razordevel/elevator/hardware overview.jpg

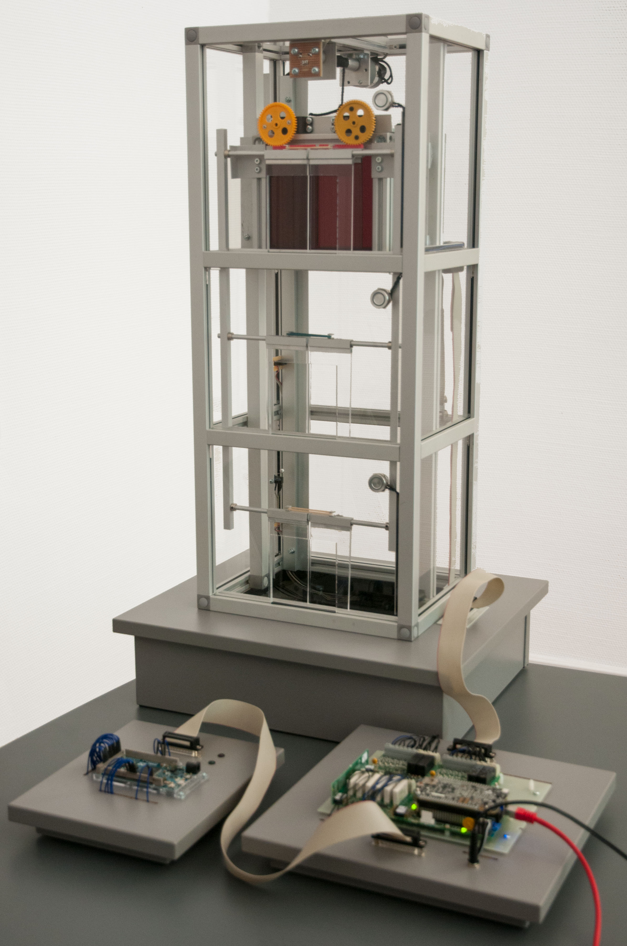
hardware overview.jpg
