razordevel/elevator/testsystem/test system.jpg

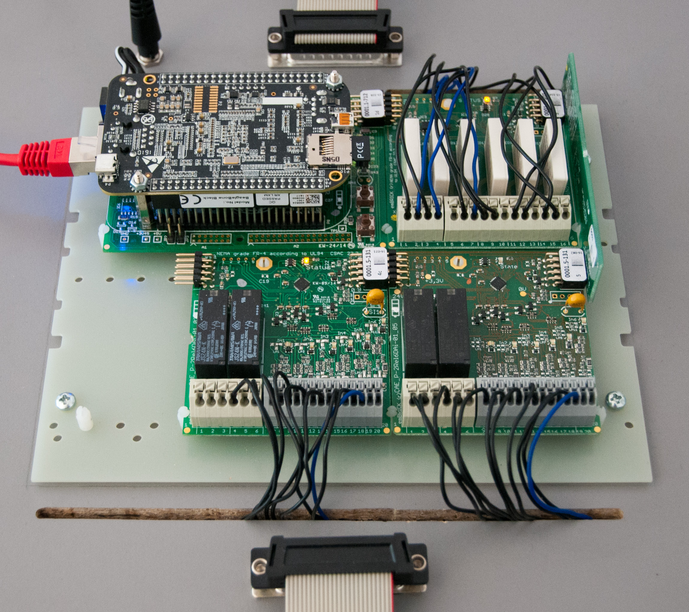
testsystem/test system.jpg
