razordevel/elevator/elevator/README.md

# Elevator

The frame of the elevator is constructed from 20mm x 20mm aluminium profiles. The walls are made out of plexiglas and are laser cutted.

The wiring picture shows how the different electrical components are wired inside the elevator.

The following list contains all major hardware components for the elevator:
#TBD

The following schematics show the assembling of the major hardware components of the elevator:
#TBD
