razordevel/elevator/elevator/Cabin Top.jpg

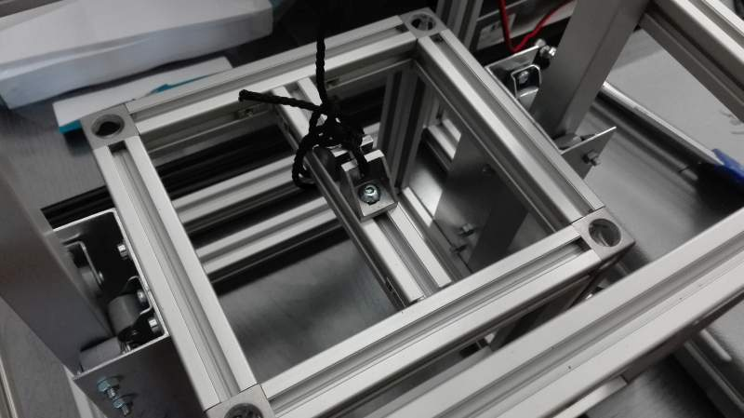
elevator/Cabin Top.jpg
