razordevel/elevator/elevator/Cabin Wheels.jpg

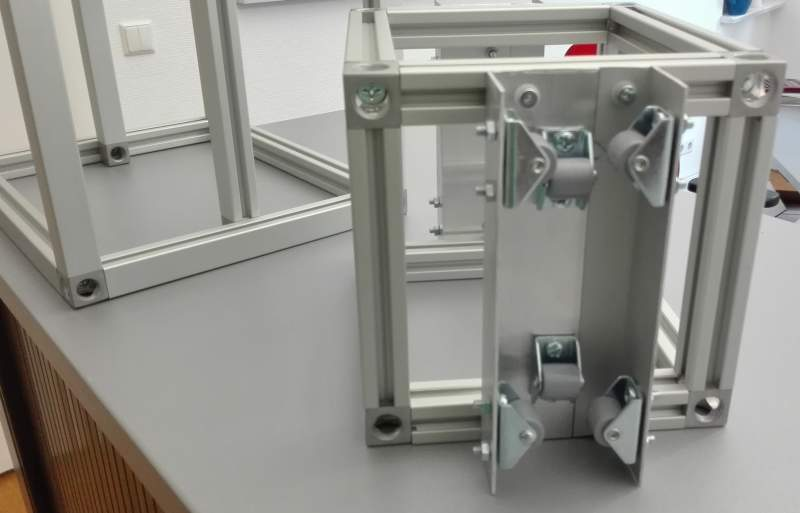
elevator/Cabin Wheels.jpg
