razordevel/elevator/elevator/Cabin.jpg

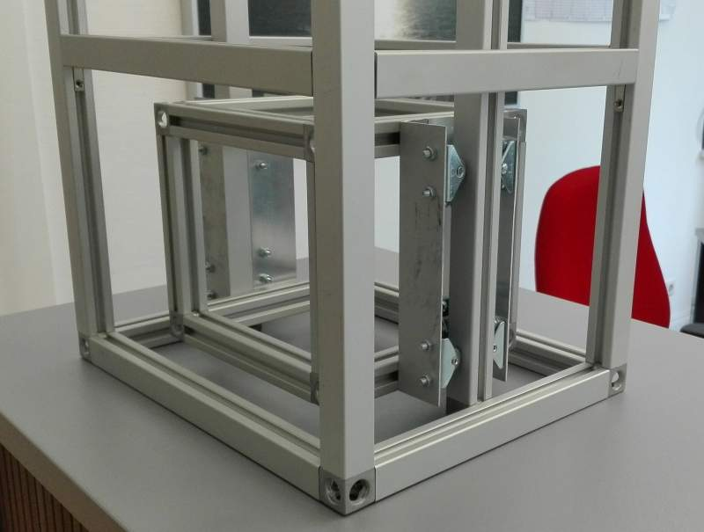
elevator/Cabin.jpg
