razordevel/elevator/elevator/Frame.jpg

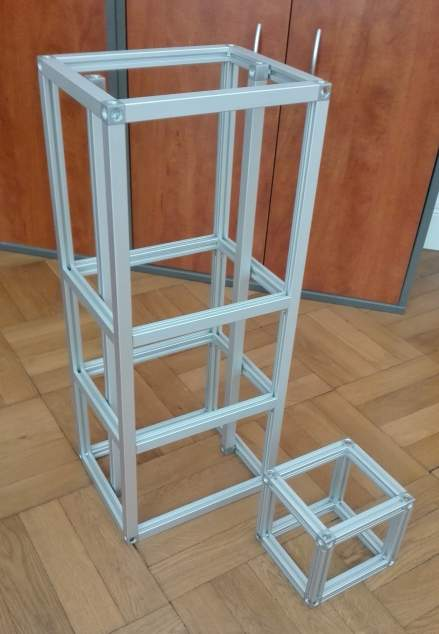
elevator/Frame.jpg
