razordevel/elevator/elevator/Motor.jpg

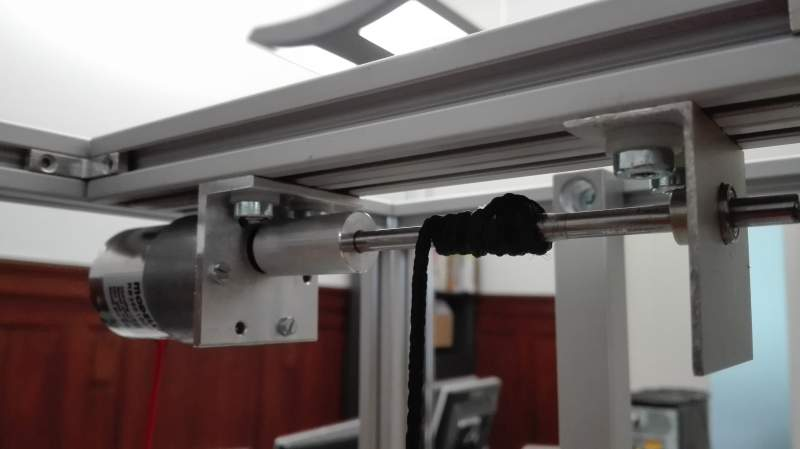
elevator/Motor.jpg
