razordevel/elevator/elevator/Overview.png

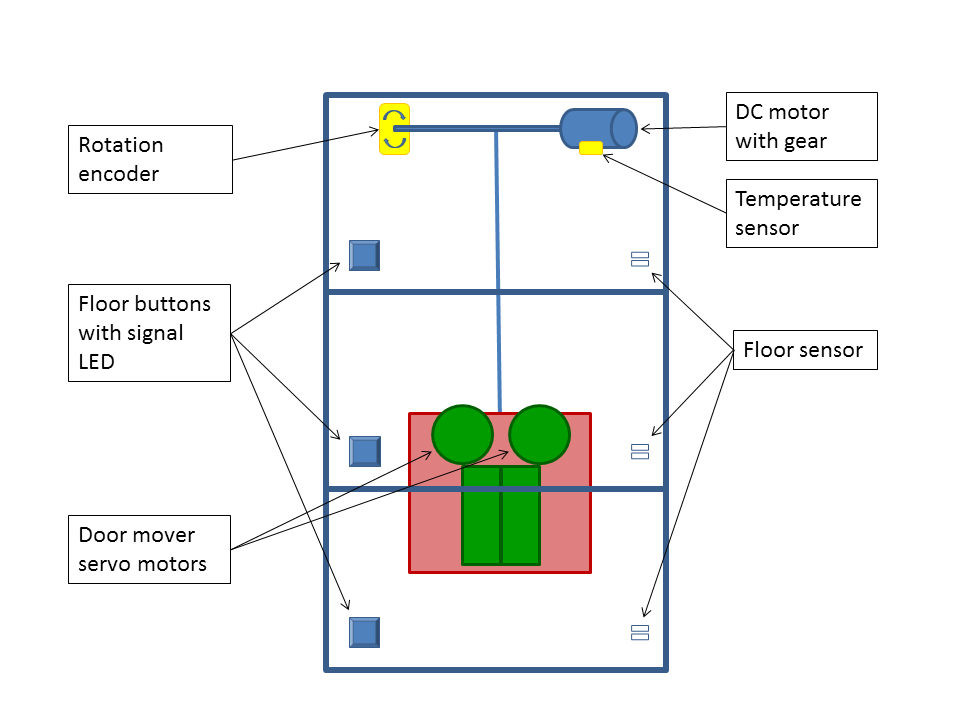
elevator/Overview.png
