razordevel/elevator/component overview.png

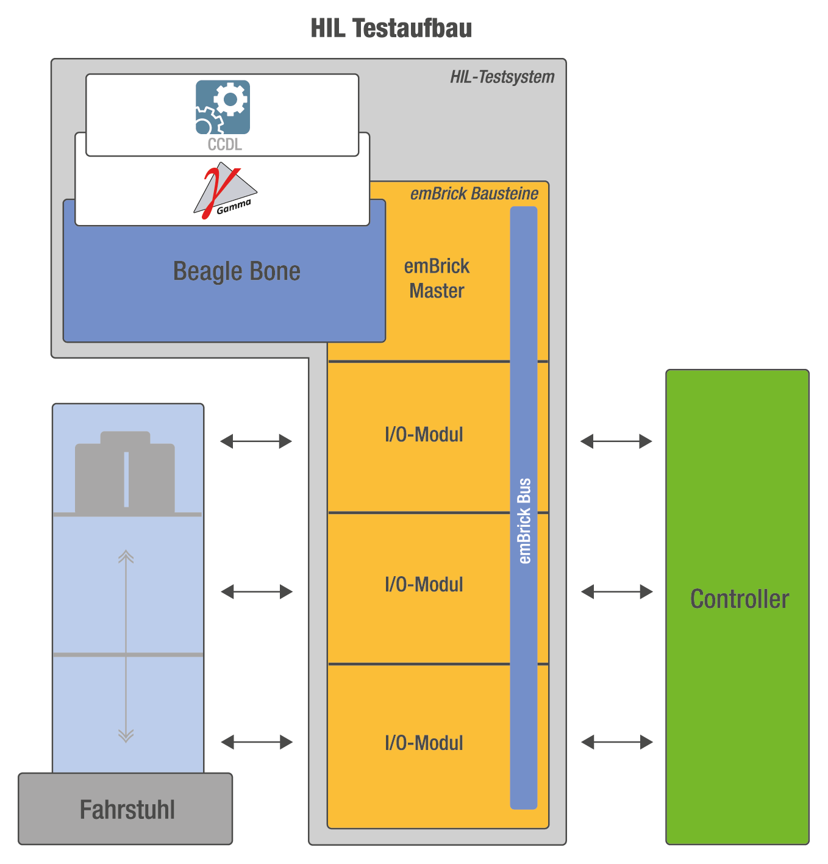
component overview.png
