razordevel/elevator/testsystem/ccdl/userfunctions/tests/00build-succeeds/README

Tests to run.
Each sub-directory contains a single test.
