razordevel/elevator/elevator/wiring.png

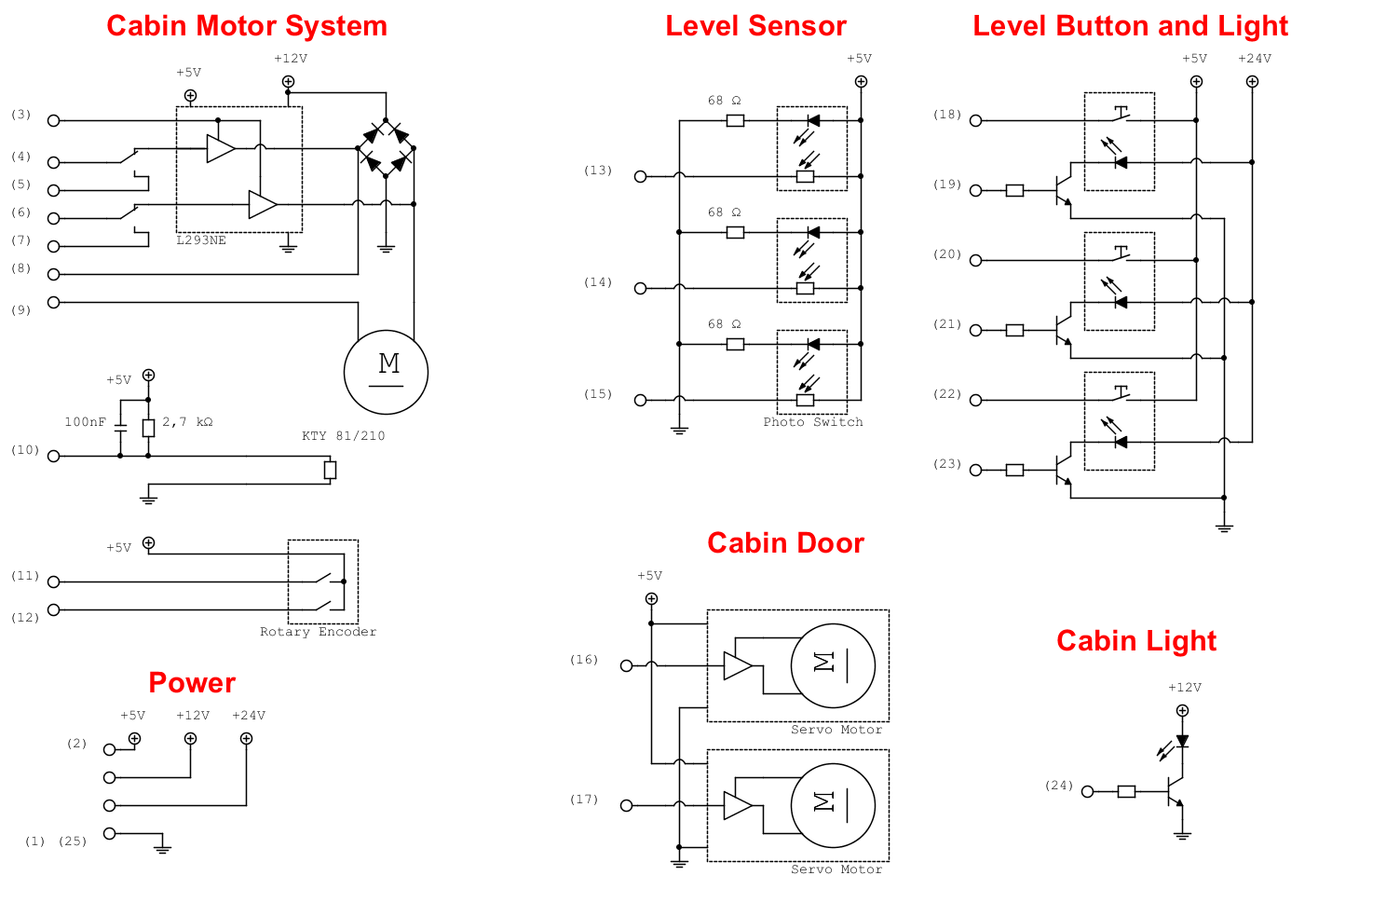
elevator/wiring.png
