razordevel/elevator/testsystem/README.md

# Test System

The hardware of the test system contains a BeagleBone Black controller, together with 4 embrick Modules: emBrick BeagleBone Master, emBrick 6 Relais Slave, emBrick 2 Relais 6 Digital Analog Input Slave.

The wiring of the test system is documented here:
#TBD

The ccdl directory contains CCDL test procedures for the demonstrator. 

To get the necessary software for a CCDL test system please contact Razorcat:
http://www.razorcat.com/
