razordevel/elevator/testsystem/ccdl/config/pins.txt

#******************************************************************************
# Version:	$Rev: 1.0 $	
#
# DESCRIPTION
# -----------
# this file contains all electrical pins which are used by the CCDL compiler
#
#******************************************************************************

SRM.ROTARY_ENCODER_A	SRM1
SRM.ROTARY_ENCODER_B	SRM1

SRM.FLOOR_LEVEL_0_SENSOR+ SRM1
SRM.FLOOR_LEVEL_1_SENSOR+ SRM1
SRM.FLOOR_LEVEL_2_SENSOR+ SRM1
