razordevel/elevator/testsystem/ccdl/userfunctions/src/userfunctions.c

/*************************************************************************
 *
 * Copyright(C) 2010-2016 Razorcat Development GmbH. All Rights Reserved.
 *
 *************************************************************************
 */

/**\file
 *    Sample user functions implemention
 *    provided with the CCDL installation package.
 */

/* Always include own header first */
#include "userfunctions.h"

#include <string.h>
#include <stdio.h>

#define true 1
#define false 0
#define boolean unsigned char

/*=========================================================================*/


// Encoder related constants
static const int ENCODER_RESOLUTION = 24;
static const long MILLI_PER_SECOND = 1000;
static const long REFERENCE_TURN = 100;
static const long STOP_TIME = 100;

// Global variables for encoder interpretion
int encoder_value = 0;
long encoder_time = 0;
long encoder_ticks = 0;
long encoder_speed = 0;
boolean encoder_overspeed = false;
long encoder_step = 0;

extern ccdl_te_parameterHandle _TDLP_DI_ROTARY_ENCODER_A;
extern ccdl_te_parameterHandle _TDLP_DI_ROTARY_ENCODER_B;
extern ccdl_te_parameterHandle _TDLP_CALC_ENCODER_SPEED;

extern ccdl_te_parameterHandle _TDLP_CTRL_DI_FLOOR_LEVEL_0_LIGHT;
extern ccdl_te_parameterHandle _TDLP_CTRL_DI_FLOOR_LEVEL_1_LIGHT;
extern ccdl_te_parameterHandle _TDLP_CTRL_DI_FLOOR_LEVEL_2_LIGHT;

static int readEncoderValue();
static void transferEncoderInput(tdl_measureSpeed_t * data);

extern int rt_gamma5x_init_srm();

#define MAINTENANCE_MODE_COUNT	82

static int maintenanceMode = false;
static int onCount;
static int offCount;
static int toleranceCount;

double tdl_initRelayMatrix(ccdl_StatementReturnType * rp, const char * module, tdl_initRelayMatrix_t * data)
{
	// Just initialize the SRM functions
	rt_gamma5x_init_srm();
	rp->code = RC_FINISHED;
	
	return 0;
}

double tdl_isInMaintenanceMode(ccdl_StatementReturnType * rp, const char * module, tdl_isInMaintenanceMode_t * data)
{
	int l0 = ccdl_te_getParValue(_TDLP_CTRL_DI_FLOOR_LEVEL_0_LIGHT);
	int l1 = ccdl_te_getParValue(_TDLP_CTRL_DI_FLOOR_LEVEL_1_LIGHT);
	int l2 = ccdl_te_getParValue(_TDLP_CTRL_DI_FLOOR_LEVEL_2_LIGHT);
	
	if (l0 == 1 && l1 == 1 && l2 == 1) {
		// All lights are on
		onCount++;
		toleranceCount = 3;
	}
	else if (l0 == 0 && l1 == 0 && l2 == 0) {
		// All lights are off
		offCount++;
		toleranceCount = 3;
	}
	else {
		// Lights are different, abort detection
		if (toleranceCount-- <= 0) {
			onCount = 0;
			offCount = 0;
			toleranceCount = 0;
			maintenanceMode = false;
		}
	}
	
	// Check if we have seen 250 ms on/off with all lights
	if (onCount >= MAINTENANCE_MODE_COUNT && offCount >= MAINTENANCE_MODE_COUNT) {
		maintenanceMode = true;
		
		// Limit counts
		onCount = MAINTENANCE_MODE_COUNT;
		offCount = MAINTENANCE_MODE_COUNT;
	}
	
	rp->code = RC_FINISHED;

	return maintenanceMode;
}

double tdl_measureSpeed(ccdl_StatementReturnType * rp, const char * module, tdl_measureSpeed_t * data)
{
	transferEncoderInput(data);

	// Will be called every 3 ms	
	data->counter += 3;
	
	rp->code = RC_FINISHED;
	
	ccdl_te_setParValue(_TDLP_CALC_ENCODER_SPEED, encoder_speed);

	return encoder_speed;
}


static int readEncoderValue() {
  int a = ccdl_te_getParValue(_TDLP_DI_ROTARY_ENCODER_A) ? 1 : 0;
  int b = ccdl_te_getParValue(_TDLP_DI_ROTARY_ENCODER_B) ? 2 : 0;
  return a + b;
}


static int getStepIndex(int value)
{
  // Rount trip cycle is 0, 2, 3, 1
  switch (value) {
      case 2:
          return 1;
      case 3: 
          return 2;
      case 1: 
          return 3;
      case 0:
      default:
          return 0;
  }
}
    
static int getInitialStep(int oldValue, int newValue)
{
        int oldStep = getStepIndex(oldValue);
        int newStep = getStepIndex(newValue);
        int step = newStep - oldStep;
        if (step == 3) {
            return -1;
        }
        if (step == -3) {
            return 1;
        }
        return step;
    }
    
static int getFastStep(int oldValue, int newValue, int direction)
{
        int oldStep = getStepIndex(oldValue);
        int newStep = getStepIndex(newValue);
        int step = newStep - oldStep;
        if (direction < 0 && step > 0) {
            step -= 4;
        }
        if (direction > 0 && step < 0) {
            step += 4;
        }
        return step;
}
 
 static void transferEncoderInput(tdl_measureSpeed_t * data)
{
	// Encoder Input
	int newValue = readEncoderValue();
	long newTime = data->counter;

        if (encoder_time == newTime) {
            return;
        }

        if (newValue != encoder_value) {
            if (encoder_speed == 0) {
                // Start into one direction
                encoder_step = getInitialStep(encoder_value, newValue);
            } else {
                // Keep direction
                encoder_step = getFastStep(encoder_value, newValue, encoder_step);
            }

            encoder_ticks += encoder_step;

            long timeDelta = newTime - encoder_time;
            long t = ENCODER_RESOLUTION * timeDelta;
            encoder_speed = encoder_step * REFERENCE_TURN * MILLI_PER_SECOND / t;

            encoder_time = newTime;
            encoder_value = newValue;
        } else if (newTime > encoder_time + STOP_TIME) {
            encoder_value = newValue;
            encoder_time = newTime;
            encoder_speed = 0;
        }
}
