razordevel/elevator/testsystem/ccdl/SRM/pi_srm.h

/*
 * Copyright 2017 Razorcat Development GmbH
 * Author: m.weber
 */


#ifndef PI_SRM_H_
#define PI_SRM_H_

/**
 * Initialises the srm facility. Invoked from the startup code.
 * @return 0 on success, -1 on failure.
 */
int rt_gamma5x_init_srm(void);

#endif /* PI_SRM_H_ */
