razordevel/elevator/(commit log)

2017-02-28 added i2c communication for register interface
2017-03-03 Fix for wrong level numbering.
    [elevat.ino]
2017-03-06 Pin layout at Arduino changed.
2017-03-06 Update for temperature read code
2017-03-07 Additional java test project to confirm encoder code.
2017-03-07 Additional test for the sensor level logic.
2017-03-07 Update for play project to find servo values.
2017-03-07 Beta controller code with cabin and door movement. All sensors working.
2017-03-08 Update for added status leds.
2017-03-10 CCDL config and userfunction implementation
    [parameter.txt]
2017-03-10 Additional test for encoder with real signals.
2017-03-10 Various updates for arduino controller code.
2017-03-11 Sample procedures and userfunction update
    [parameter.txt]
2017-03-12 New encoder variant to handle embrick resolution problems.
2017-03-12 Minor update to call millis() only once per cycle.
2017-03-12 Update for i2c request
2017-04-26 Moved config directory
    [parameter.txt]
2017-06-30 EW 2017 samples and TESSY project added
2017-08-17 New project structure and additional documentation.
    [parameter.txt]
2017-09-05 Additional images of the elevator and cabin aluminium frames.
2018-02-22 Update for controller code.
    The initialize of the elevator will now try to move the cabin to the
    ground floor.
2018-02-23 SRM sample implementation
2018-02-23 Added missing Arduino header files
2018-02-23 Logbook entries for demo, new parameters for CCDL added
    [parameter.txt]
2018-02-23 Updated CCDL sample procedures
2018-02-23 Moved userfunctions/SRM directory and other files
    [parameter.txt]
2020-11-27 Manual mode added in arduino code
